SobieskiSat/ElectronicDesign20/README.txt

View this project on [CADLAB.io](https://cadlab.io/project/2295). 

Electronic design of the mainboard. more details TBA.
