SobieskiSat/ElectronicDesign20/projects/CanSat/Czopolot 2.0/Gerbers/Czopolot_Final1_1/CAMOutputs/Assembly/PnP_Schematic_back.txt

BTN_DFU	36.75	30.40	0.00	SLIDE-SWITCH2	SLIDE-SWITCH-2
BTN_RST	15.25	30.75	0.00	PUSH-SWITCH	SWITCH_SMD
BTN_USR	21.25	31.25	0.00	PUSH-SWITCH	SWITCH_SMD
BTN_USR1	27.25	31.25	0.00	PUSH-SWITCH	SWITCH_SMD
C16	31.20	30.85	90.00	4.7u	C0603
C28	50.25	12.75	180.00		153CLV-0405
C30	55.25	17.00	90.00	470n	C0603
C31	45.50	13.00	270.00	10u	C1206
C32	17.00	10.25	270.00	100n	C0603
C5	21.75	21.00	90.00	100n	C0603
C71	21.75	24.50	90.00	10n	C0603
LEDA	5.25	30.75	0.00	LED0805	CHIPLED_0805
LEDB	7.25	30.75	0.00	LED0805	CHIPLED_0805
LEDC	9.25	30.75	0.00	LED0805	CHIPLED_0805
LEDCH	55.25	20.75	0.00	LED0805	CHIPLED_0805
LEDD	11.25	30.75	0.00	LED0805	CHIPLED_0805
LEDP	45.25	20.75	0.00	LED0805	CHIPLED_0805
LM3940IMP	50.25	20.50	90.00	REGULATOR	SOT230P700X180-4N
R30	46.50	23.75	180.00	560R	R0603
R4	14.38	6.25	270.00	100k	R0603
R8	54.00	23.75	180.00	1k	R0603
R9	54.25	14.25	180.00	0R	R0603
U$13	35.00	4.98	180.00	MOTOR_DUO	4(2)X_JSTSMD_F
U$14	50.25	4.98	180.00	BAT_JST_4(3)	4(3)X_JSTSMD_F
U$17	22.00	4.98	180.00	MOTOR_DUO	4(2)X_JSTSMD_F
U$20	7.75	4.98	180.00	CONNECTOR_F_X3_JST_SMD	3X_JSTSMD_F
U$21	10.75	20.25	0.00	LORADUO	MODULE_SX1280
U$3	32.25	19.75	180.00	L86	L86
U$7	50.25	28.21	180.00	USB2.0	USB-C(2)
