SobieskiSat/ElectronicDesign20/projects/CanSat/Czopolot 2.0/Gerbers/Czopolot_Final1_1/CAMOutputs/Assembly/PnP_Schematic_front.txt

C0	5.75	24.50	180.00	100n	C0603
C1	8.50	9.50	225.00	100n	C0603
C11	11.75	31.25	0.00	100n	C0603
C12	6.25	17.75	270.00	15p	C0603
C13	1.75	21.50	90.00	15p	C0603
C14	2.25	24.50	180.00	10p	C0603
C15	6.25	21.50	90.00	10p	C0603
C17	28.50	8.00	90.00	100n	C0603
C18	41.50	8.00	90.00	100n	C0603
C19	28.50	4.75	0.00	10u	C1206
C20	45.50	22.50	270.00	1u	C0603
C21	50.25	23.25	180.00	33n	C0603
C22	47.50	22.50	90.00	1u	C0603
C23	55.00	14.00	270.00	1u	C0603
C24	55.00	18.50	270.00	22n	C0603
C25	41.50	4.75	180.00	10u	C1206
C26	39.50	8.00	90.00	50p	C0603
C27	26.50	8.00	90.00	50p	C0603
C3	24.25	22.25	0.00	100n	C0603
C4	11.75	26.75	0.00	100n	C0603
C50	11.75	28.75	0.00	1u	C0603
C6	4.00	14.00	270.00	4.7u	C0603
C7	1.75	14.00	270.00	100n	C0603
C70	24.25	28.75	180.00	100n	C0603
C72	24.25	26.75	0.00	100n	C0603
C8	17.25	9.50	225.00	2.2u	C0603
C80	9.00	30.50	90.00	10u	C0603
C9	24.25	20.00	0.00	2.2u	C0603
CBK	3.50	27.25	180.00	11m	CPH3225A
D1	7.00	30.50	90.00	DIODE	R0603
F1	6.25	14.00	90.00	1k	R0603
L2	54.50	22.50	315.00	1uH	INDUCTOR_VISHAY
R0	24.25	17.75	180.00	100k	R0603
R1	28.50	10.75	180.00	10k	R0603
R2	30.50	8.00	90.00	100k	R0603
R20	45.50	18.50	270.00	10k	R0603
R21	53.00	14.00	90.00	125R	R0603
R22	45.50	14.00	90.00	1k(NTC)/5k	R0603
R23	47.50	14.00	270.00	2k(NTC)/5k	R0603
R24	50.25	13.25	0.00	0R	R0603
R3	28.50	13.00	0.00	10k	DR0603
R5	39.00	10.75	180.00	10k	R0603
R6	5.00	30.50	90.00	0R	R0603
R7	38.25	13.00	0.00	10k	DR0603
U$1	14.50	17.75	0.00	STM32F405RGT6	QFP50P1200X1200X160-64N
U$10	50.25	18.50	45.00	BQ24253	QFN50P400X400X100-25T270N
U$11	35.00	8.00	270.00	TC78H653FTG	QFN50P300X300X90-17T170N
U$12	22.00	8.00	270.00	TC78H653FTG	QFN50P300X300X90-17T170N
U$15	19.75	31.25	180.00	RESISTORARRAY	0603-ARC
U$16	24.25	31.25	180.00	RESISTORARRAY	0603-ARC
U$19	50.25	5.23	180.00	CONNECTOR_F_X3_JST_SMD	3X_JSTSMD_F
U$2	34.16	23.06	0.00	MICROSD_HOLDER	MICROSD_HOLDER
U$26	15.25	31.25	180.00	RESISTORARRAY	0603-ARC
U$4	8.00	27.00	180.00	RESISTORARRAY	0603-ARC
U$5	4.00	21.50	270.00	32.768kHz / 12.5pF	OSC32X15
U$6	3.00	17.75	0.00	12MHz / 20pF	OSCCC320X250X80N
U$7	50.25	28.21	180.00	USB2.0	USB-C(2)
U$8	15.25	27.75	0.00	BMP280	BMP280
U$9	19.75	27.75	0.00	MPU9250USR	MPU9250
X1	10.25	5.13	0.00	FH12-24S-0.5SH	FH12-24S-0.5SH
