SobieskiSat/ElectronicDesign20/projects/CanSat/Czopolot 2.0/Prototype2_AssemblyDoc.pdf

# BQ24253 PAD 25

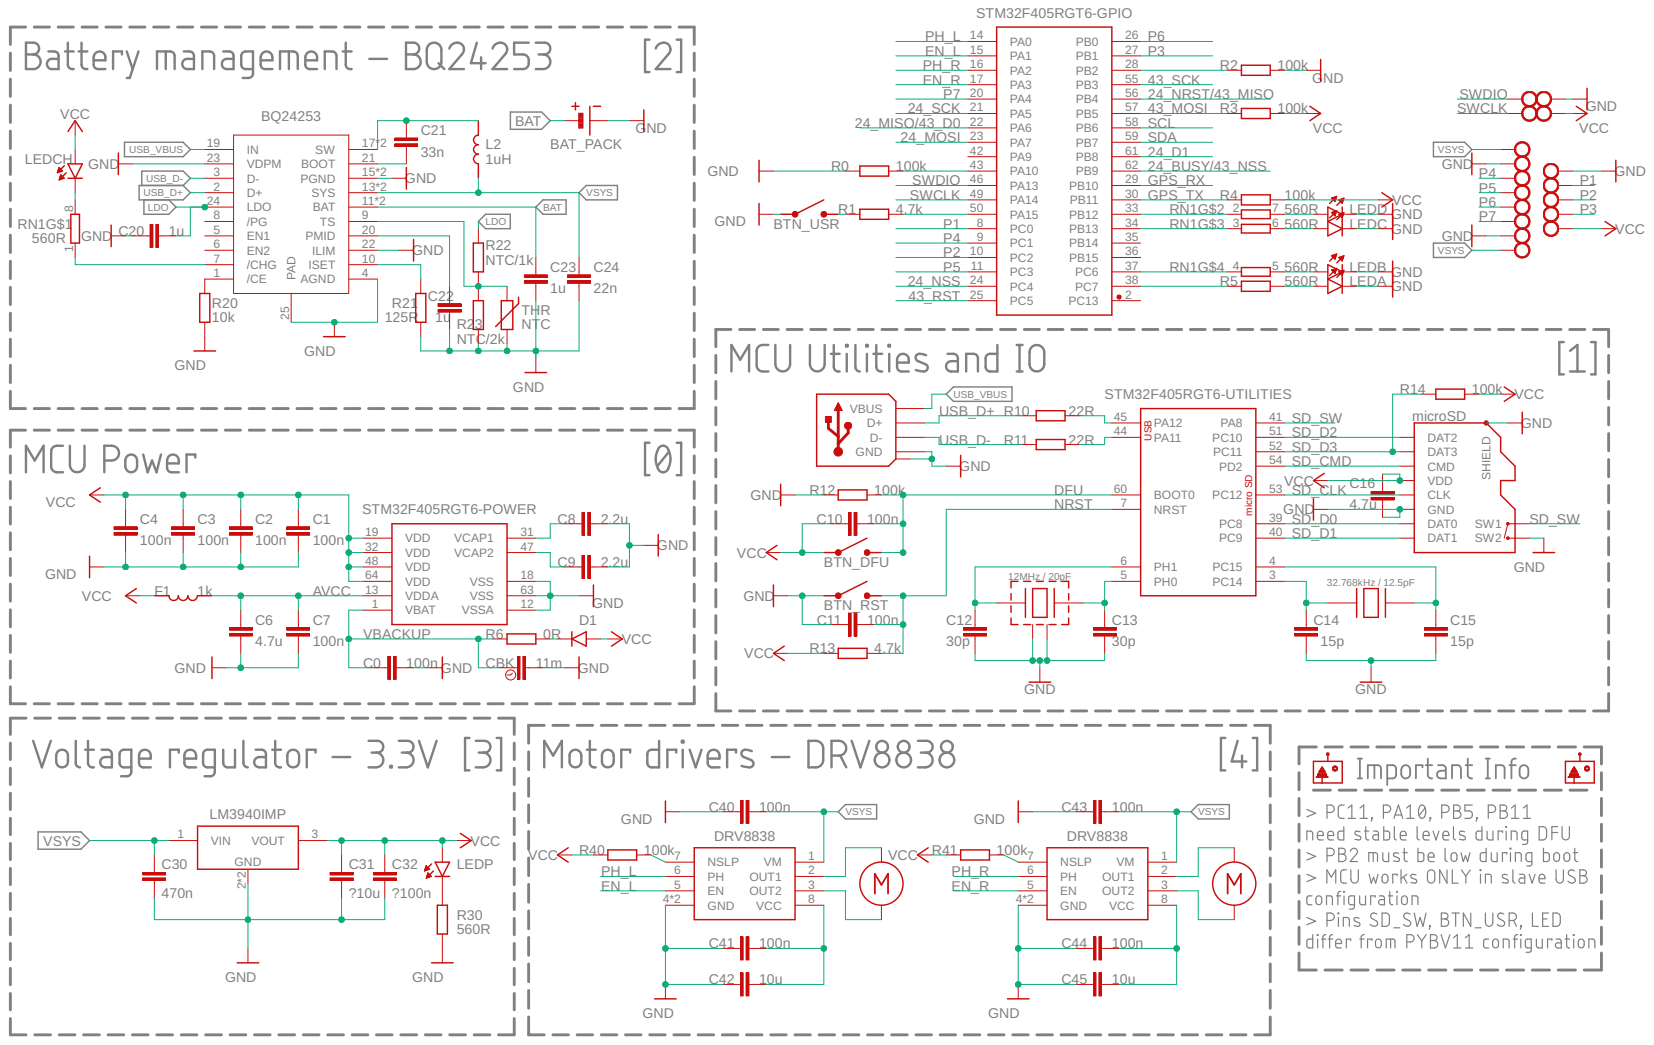
[picture p1: page 1]

NRST | NRST 7 | GND

BOM by part | | BOM by value
MCU ID: 0 | LDO ID: 3 | Cap | Res

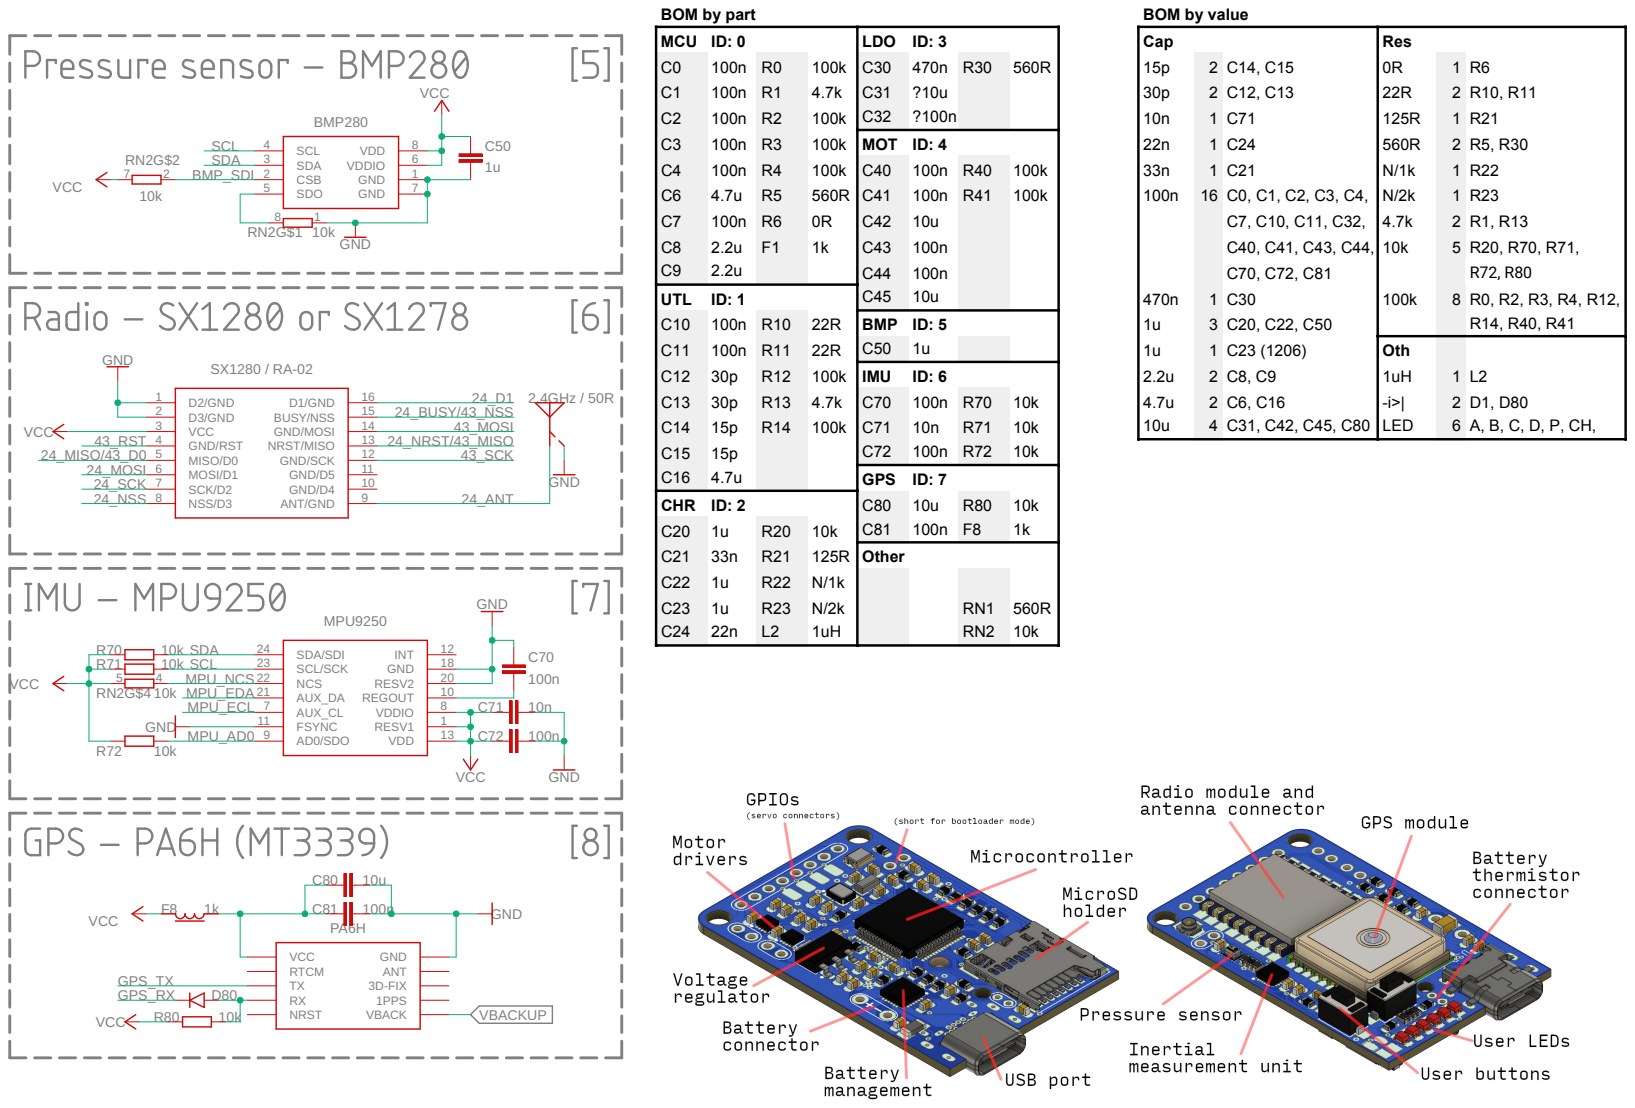
[picture p2: page 2]

## GND

1

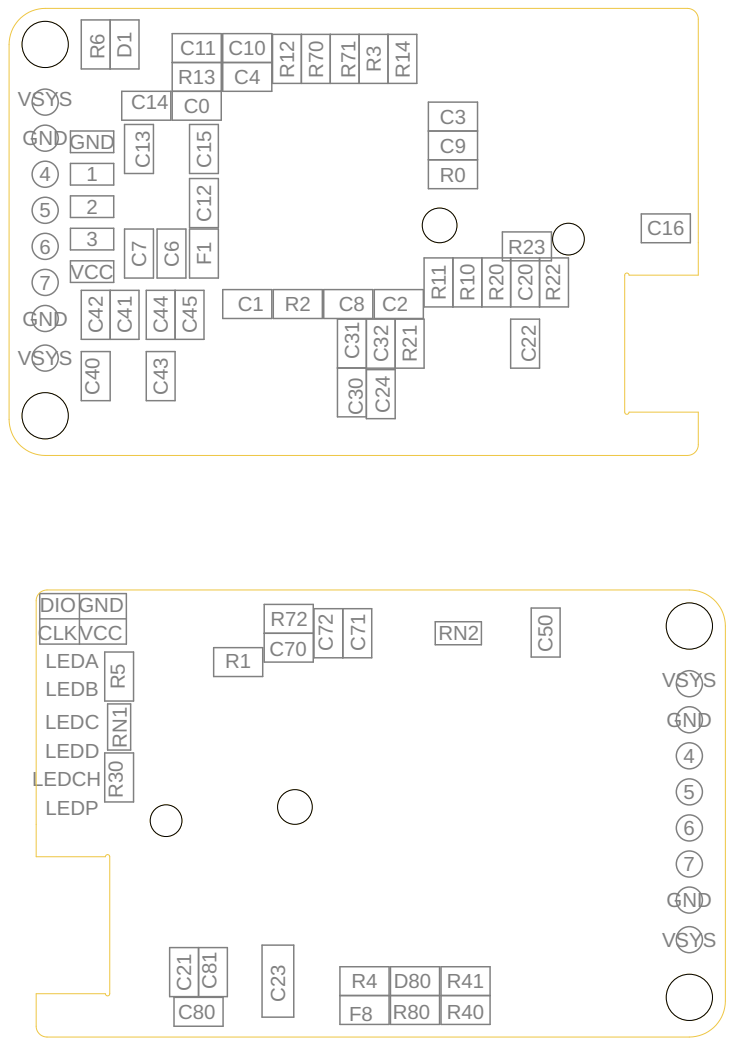
[picture p3: page 3]

DIO | GND

CLKVCC
