SobieskiSat/ElectronicDesign20/projects/CanSat/ExpansionBoard/ExpansionBoard.brd

## EAGLE design projects/CanSat/ExpansionBoard/ExpansionBoard.brd (2020-07-03)

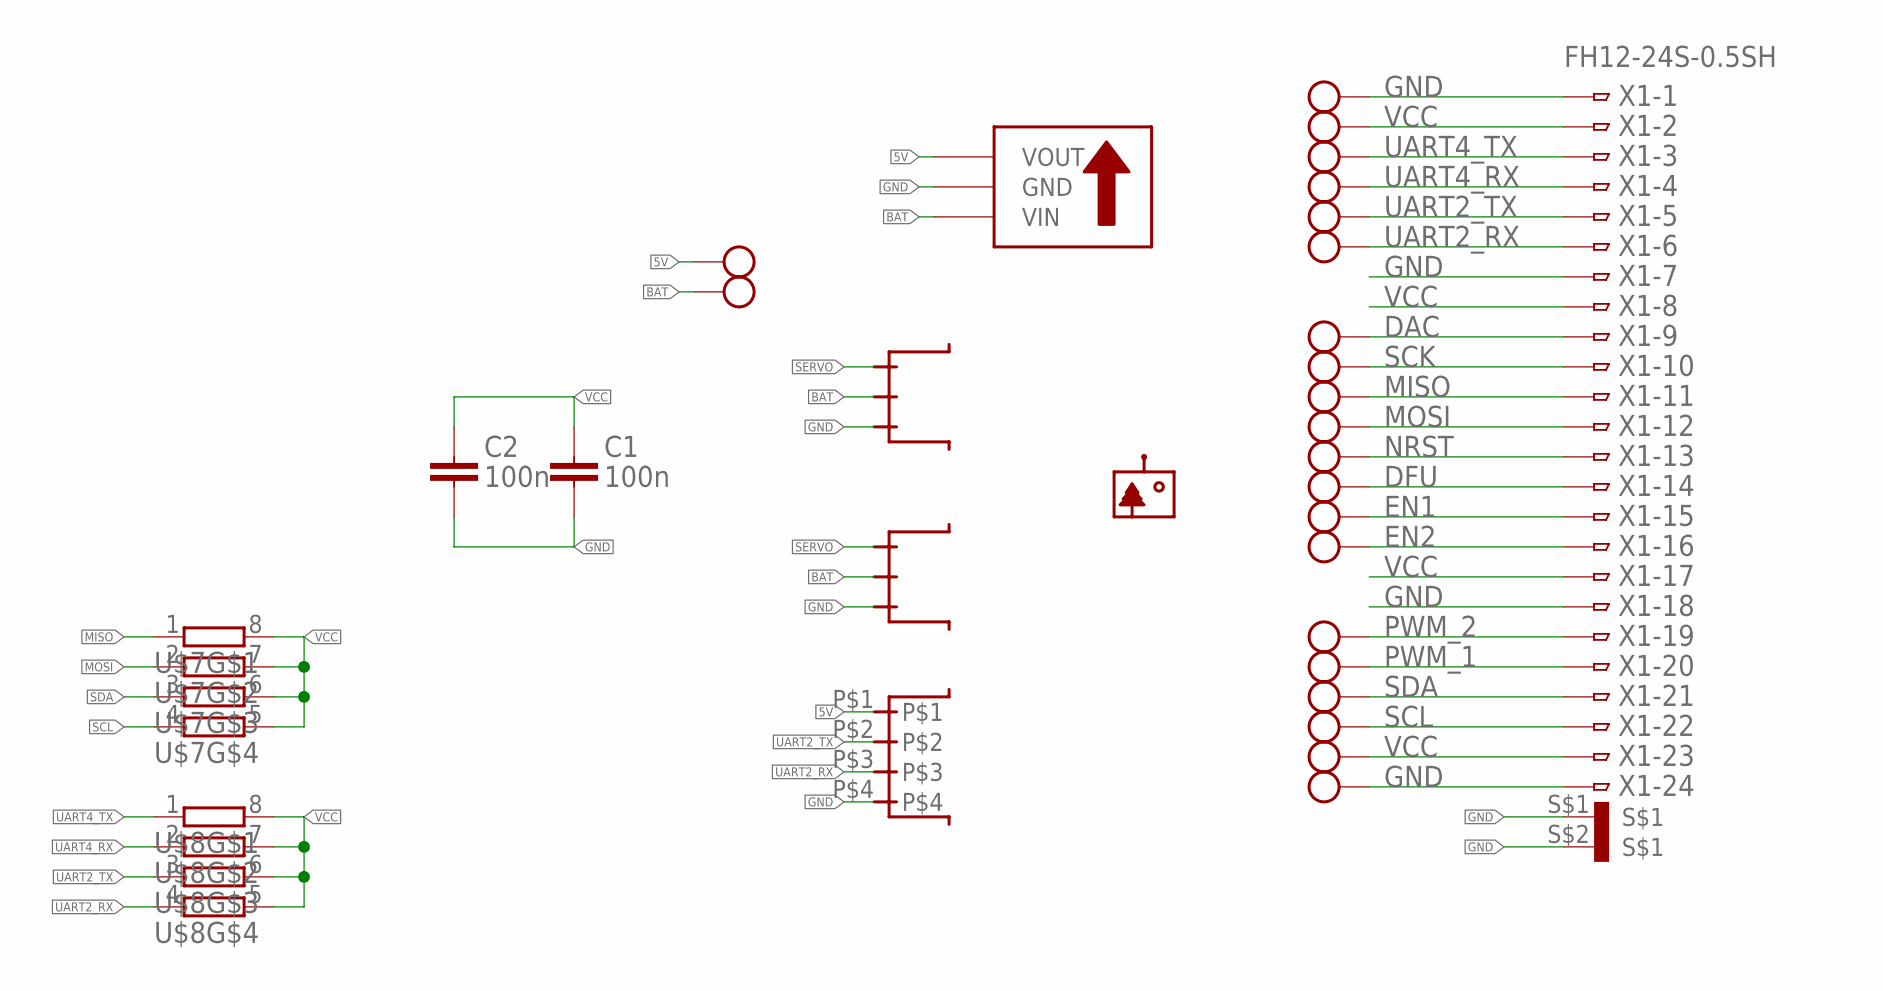
[picture p4: schematic ExpansionBoard.sch]

Parts:
C1, C2: 100n; C0603
U$1, U$23: THT_PADSQ; THT_PAD_SQ
U$2, U$3, U$4, U$5, U$6, U$9, U$10, U$11, U$12, U$13, U$14, U$15, U$16, U$19, U$20, U$21, U$22, U$24, U$27, U$30: THT_PAD
U$7, U$8: RESISTORARRAY; 0603-ARC
U$17: LOGOSQSM
U$25: MODULE_STEPUP
U$26: CONNECTOR_F_X4_JST_SMD; 4X_JSTSMD_F
U$28, U$29: CONNECTOR_F_X3_JST_SMD; 3X_JSTSMD_F
X1: FH12-24S-0.5SH

Connections:
5V: U$25.VOUT, U$26.P$1, U$27.P$1
BAT: U$25.VIN, U$28.P$2, U$29.P$2, U$30.P$1
DAC: U$9.P$1, X1.9 (1)
DFU: U$14.P$1, X1.14 (1)
EN1: U$15.P$1, X1.15 (1)
EN2: U$16.P$1, X1.16 (1)
GND: C1.2, C2.2, U$1.P$1, U$23.P$1, U$25.GND, U$26.P$4, U$28.P$3, U$29.P$3, X1.1, X1.7 (1), X1.18 (1), X1.24 (1), X1.S$1, X1.S$2
MISO: U$7.1, U$11.P$1, X1.11 (1)
MOSI: U$7.2 (1), U$12.P$1, X1.12 (1)
NRST: U$13.P$1, X1.13 (1)
PWM_1: U$20.P$1, X1.20 (1)
PWM_2: U$19.P$1, X1.19 (1)
SCK: U$10.P$1, X1.10 (1)
SCL: U$7.4 (1), U$22.P$1, X1.22 (1)
SDA: U$7.3 (1), U$21.P$1, X1.21 (1)
SERVO: U$28.P$1, U$29.P$1
UART2_RX: U$6.P$1, U$8.4 (1), U$26.P$3, X1.6 (1)
UART2_TX: U$5.P$1, U$8.3 (1), U$26.P$2, X1.5 (1)
UART4_RX: U$4.P$1, U$8.2 (1), X1.4 (1)
UART4_TX: U$3.P$1, U$8.1, X1.3 (1)
VCC: C1.1, C2.1, U$2.P$1, U$7.5 (2), U$7.6 (2), U$7.7 (2), U$7.8 (2), U$8.5 (2), U$8.6 (2), U$8.7 (2), U$8.8 (2), U$24.P$1, X1.2 (1), X1.8 (1), X1.17 (1), X1.23 (1)

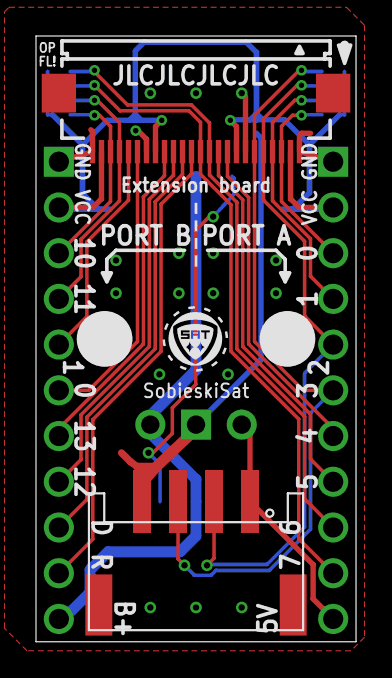
[picture p5: board ExpansionBoard.brd from above]

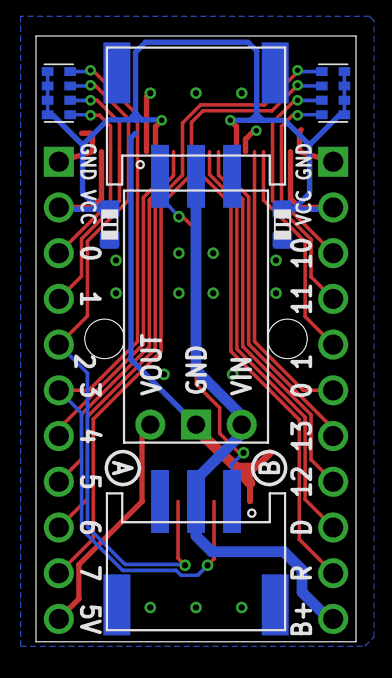
[picture p6: board ExpansionBoard.brd from below]

Board: 2 copper layers, 17.8 x 33.7 mm, 32 parts (7 on the bottom side), 21 nets.
