SobieskiSat/ElectronicDesign20/projects/CanSat/Czopolot 2.0/Schematic.brd

## EAGLE design projects/CanSat/Czopolot 2.0/Schematic.brd (2020-07-03)

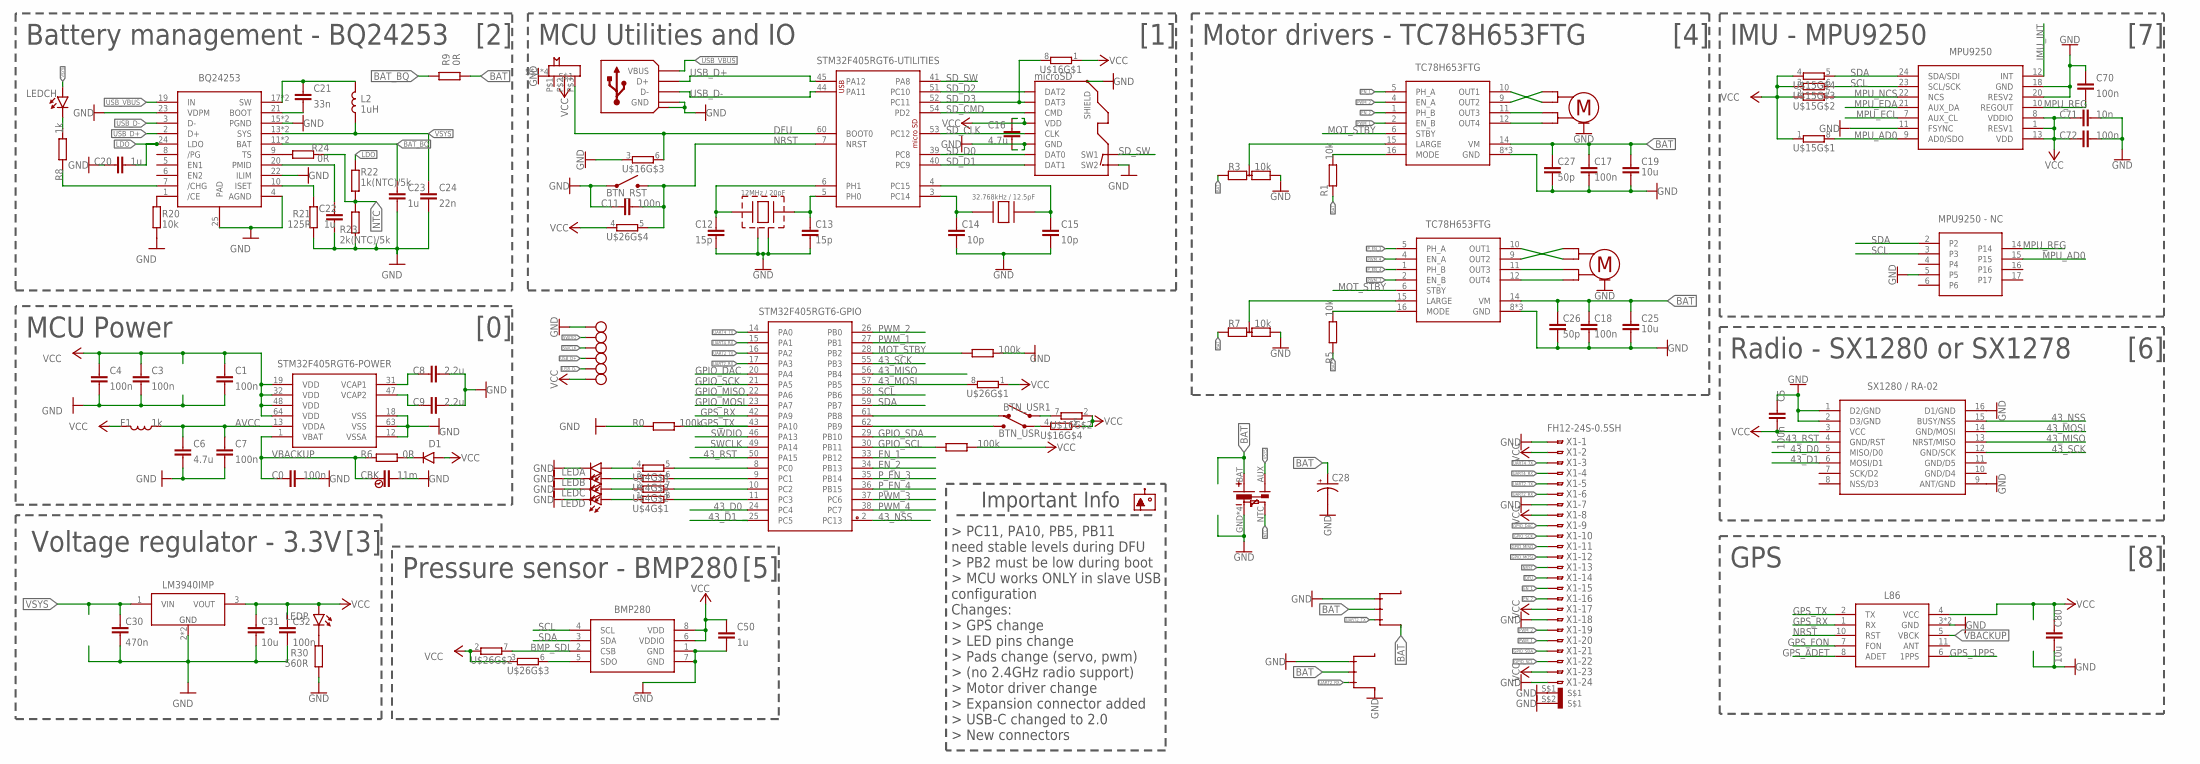
[picture p7: schematic Schematic.sch]

Parts:
BTN_DFU: SLIDE-SWITCH2; SLIDE-SWITCH-2
BTN_RST: PUSH-SWITCH; SWITCH_SMD
BTN_USR, BTN_USR1: PUSH-SWITCH; SWITCH_SMD
C0, C1, C3, C4, C5, C7, C11, C17, C18, C32, C70, C72: 100n; C0603
C6, C16: 4.7u; C0603
C8, C9: 2.2u; C0603
C12, C13: 15p; C0603
C14, C15: 10p; C0603
C19, C25, C31: 10u; C1206
C20, C22, C23, C50: 1u; C0603
C21: 33n; C0603
C24: 22n; C0603
C26, C27: 50p; C0603
C28: CPOL-US153CLV-0405; 153CLV-0405
C30: 470n; C0603
C71: 10n; C0603
C80: 10u; C0603
CBK: 11m; CPH3225A
D1: DIODE; R0603
F1: 1k; R0603
L2: 1uH; INDUCTOR_VISHAY
LEDA: LED0805; CHIPLED_0805
LEDB: LED0805; CHIPLED_0805
LEDC: LED0805; CHIPLED_0805
LEDCH: LED0805; CHIPLED_0805
LEDD: LED0805; CHIPLED_0805
LEDP: LED0805; CHIPLED_0805
LM3940IMP: REGULATOR; SOT230P700X180-4N
R0, R2, R4: 100k; R0603
R1, R5, R20: 10k; R0603
R3, R7: 10k; DR0603
R6, R9, R24: 0R; R0603
R8: 1k; R0603
R21: 125R; R0603
R22: 1k(NTC)/5k; R0603
R23: 2k(NTC)/5k; R0603
R30: 560R; R0603
U$1: STM32F405RGT6; QFP50P1200X1200X160-64N
U$2: MICROSD_HOLDER
U$3: L86
U$4, U$15, U$16, U$26: RESISTORARRAY; 0603-ARC
U$5: 32.768kHz / 12.5pF; OSC32X15
U$6: 12MHz / 20pF; OSCCC320X250X80N
U$7: USB2.0; USB-C(2)
U$8: BMP280
U$9: MPU9250USR; MPU9250
U$10: BQ24253; QFN50P400X400X100-25T270N
U$11, U$12: TC78H653FTG; QFN50P300X300X90-17T170N
U$13, U$17: MOTOR_DUO; 4(2)X_JSTSMD_F
U$14: BAT_JST_4(3); 4(3)X_JSTSMD_F
U$18: LOGOSQSM
U$19, U$20: CONNECTOR_F_X3_JST_SMD; 3X_JSTSMD_F
U$21: LORADUO; MODULE_SX1280
U$25: GPIO_DEBUG
X1: FH12-24S-0.5SH

Connections:
43_D0: U$1.24 (PC4), U$21.5 (MISO/D0)
43_D1: U$1.25 (PC5), U$21.6 (MOSI/D1)
43_MISO: U$1.56 (PB4), U$21.13 (NRST/MISO)
43_MOSI: U$1.57 (PB5), U$21.14 (GND/MOSI), U$26.8 (2)
43_NSS: U$1.2 (PC13), U$21.15 (BUSY/NSS)
43_RST: U$1.50 (PA15), U$21.4 (GND/RST)
43_SCK: U$1.55 (PB3), U$21.12 (GND/SCK)
AVCC: C6.1, C7.1, F1.2, U$1.13 (VDDA)
BAT: C17.1, C18.1, C19.1, C25.1, C26.1, C27.1, C28.+, R1.1, R3.2, R5.1, R7.2, R9.1, U$11.14 (VM), U$12.14 (VM), U$14.BAT (+), U$19.P$2, U$19.S$1, U$19.S$2, U$20.P$2
BAT_BQ: C23.1, R9.2, U$10.11 (BAT), U$10.12 (BAT)
BMP_SDI: U$8.2 (CSB), U$26.7 (2)
BMP_SDO: U$8.5 (SDO), U$26.6 (2)
DFU: BTN_DFU.P$3, U$1.60 (BOOT0), U$16.6 (2), X1.14 (1)
EN_1: U$1.33 (PB12), U$12.5 (PH_A), X1.15 (1)
EN_2: U$1.34 (PB13), U$12.1 (PH_B), X1.16 (1)
GND: BTN_DFU.S$1, BTN_DFU.S$2, BTN_DFU.S$3, BTN_DFU.S$4, BTN_RST.P$1, BTN_RST.P$4, C0.2, C1.2, C3.2, C4.2, C5.1, C6.2, C7.2, C8.2, C9.2, C11.1, C12.2, C13.2, C14.2, C15.2, C16.1, C17.2, C18.2, C19.2, C20.1, C22.2, C23.2, C24.2, C25.2, C26.2, C27.2, C28.-, C30.2, C31.2, C32.2, C50.2, C70.1, C71.2, C72.2, C80.2, CBK.P$2 (2), LEDA.C, LEDB.C, LEDC.C, LEDD.C, LM3940IMP.2 (GND), LM3940IMP.4 (GND), R0.1, R2.1, R3.3, R7.3, R20.1, R21.1, R23.1, R30.2, U$1.12 (VSSA), U$1.18 (VSS), U$1.63 (VSS), U$2.GND, U$2.SHIELD@1 (SHIELD), U$2.SHIELD@2 (SHIELD), U$2.SHIELD@3 (SHIELD), U$2.SHIELD@4 (SHIELD), U$2.SW2, U$3.3 (GND), U$3.12 (GND), U$6.2 (GND), U$6.4 (GND), U$7.A1 (GND), U$7.A12 (GND), U$7.B1 (GND), U$7.B12 (GND), U$7.MID@1 (SHIELD), U$7.MID@2 (SHIELD), U$7.S$1 (GND), U$7.S$2 (GND), U$7.S$3 (GND), U$7.S$4 (GND), U$7.S$5 (GND), U$7.S$6 (GND), U$7.S$7 (GND), U$7.S$8 (GND), U$8.1 (GND), U$8.7 (GND), U$9.5, U$9.11 (FSYNC), U$9.18 (GND), U$9.20 (RESV2), U$10.4 (AGND), U$10.15 (PGND), U$10.16 (PGND), U$10.22 (ILIM), U$10.23 (VDPM), U$10.25 (PAD), U$11.8 (GND), U$11.13 (GND), U$11.17 (GND), U$12.8 (GND), U$12.13 (GND), U$12.17 (GND), U$13.S$1, U$13.S$2, U$13.S$3, U$13.S$4, U$14.GND (-), U$14.S$1 (-), U$14.S$2 (-), U$14.S$3 (-), U$16.3 (1), U$17.S$1, U$17.S$2, U$17.S$3, U$17.S$4, U$19.P$1, U$20.P$1, U$20.S$1, U$20.S$2, U$21.1 (D2/GND), U$21.2 (D3/GND), U$21.9 (ANT/GND), U$21.16 (D1/GND), U$25.P$1, X1.1, X1.7 (1), X1.18 (1), X1.24 (1), X1.S$1, X1.S$2
GPIO_DAC: U$1.20 (PA4), X1.9 (1)
GPIO_MISO: U$1.22 (PA6), X1.11 (1)
GPIO_MOSI: U$1.23 (PA7), X1.12 (1)
GPIO_SCK: U$1.21 (PA5), X1.10 (1)
GPIO_SCL: R4.2, U$1.30 (PB11), X1.22 (1)
GPIO_SDA: U$1.29 (PB10), X1.21 (1)
GPS_1PPS: U$3.6 (1PPS)
GPS_ADET: U$3.8 (ADET)
GPS_FON: U$3.7 (FON)
GPS_RX: U$1.42 (PA9), U$3.1 (RX)
GPS_TX: R0.2, U$1.43 (PA10), U$3.2 (TX)
IMU_INT: U$9.12 (INT)
LDO: C20.2, R22.2, U$10.24 (LDO)
MOT_STBY: R2.2, U$1.28 (PB2), U$11.6 (STBY), U$12.6 (STBY)
MPU_AD0: U$9.9 (AD0/SDO), U$9.15, U$15.8 (2)
MPU_ECL: U$9.7 (AUX_CL)
MPU_EDA: U$9.21 (AUX_DA)
MPU_NCS: U$9.22 (NCS), U$15.7 (2)
MPU_REG: C70.2, U$9.10 (REGOUT), U$9.14
unnamed: LEDD.A, U$4.1
unnamed: LEDC.A, U$4.2 (1)
unnamed: LEDCH.C, R8.2
unnamed: U$11.9 (OUT2), U$13.P$1
unnamed: BTN_USR.P$2, BTN_USR.P$3, U$1.62 (PB9)
unnamed: C21.2, U$10.21 (BOOT)
unnamed: BTN_USR.P$1, BTN_USR.P$4, U$16.4 (1)
unnamed: C9.1, U$1.47 (VCAP2)
unnamed: C8.1, U$1.31 (VCAP1)
unnamed: R8.1, U$10.7 (/CHG)
unnamed: C12.1, U$1.6 (PH1), U$6.1
unnamed: C13.1, U$1.5 (PH0), U$6.3
unnamed: C14.1, U$1.3 (PC14), U$5.P$1
unnamed: C15.1, U$1.4 (PC15), U$5.P$2
unnamed: U$1.8 (PC0), U$4.5 (2)
unnamed: R24.2, U$10.9 (TS)
unnamed: R21.2, U$10.10 (ISET)
unnamed: U$1.11 (PC3), U$4.8 (2)
unnamed: U$1.10 (PC2), U$4.7 (2)
unnamed: C21.1, L2.P$1, U$10.17 (SW), U$10.18 (SW)
unnamed: LEDP.C, R30.1
unnamed: U$11.10 (OUT1), U$13.P$2
unnamed: C22.1, U$10.20 (PMID)
unnamed: BTN_USR1.P$1, BTN_USR1.P$4, U$16.7 (2)
unnamed: U$1.9 (PC1), U$4.6 (2)
unnamed: R20.2, U$10.1 (/CE)
unnamed: BTN_USR1.P$2, BTN_USR1.P$3, U$1.61 (PB8)
unnamed: U$11.11 (OUT3), U$13.P$3
unnamed: U$11.12 (OUT4), U$13.P$4
unnamed: U$12.9 (OUT2), U$17.P$1
unnamed: U$12.10 (OUT1), U$17.P$2
unnamed: U$12.11 (OUT3), U$17.P$3
unnamed: U$12.12 (OUT4), U$17.P$4
unnamed: R1.2, U$12.16 (MODE)
unnamed: LEDB.A, U$4.3 (1)
unnamed: LEDA.A, U$4.4 (1)
unnamed: R3.1, U$12.15 (LARGE)
unnamed: R5.2, U$11.16 (MODE)
unnamed: D1.2, R6.2
unnamed: R7.1, U$11.15 (LARGE)
NRST: BTN_RST.P$2, BTN_RST.P$3, C11.2, U$1.7 (NRST), U$3.10 (RST), U$26.5 (2), X1.13 (1)
NTC: R22.1, R23.2, R24.1, U$14.NTC
PWM_1: U$1.27 (PB1), U$12.2 (EN_B), X1.20 (1)
PWM_2: U$1.26 (PB0), U$12.4 (EN_A), X1.19 (1)
PWM_3: U$1.37 (PC6), U$11.2 (EN_B)
PWM_4: U$1.38 (PC7), U$11.4 (EN_A)
P_EN_3: U$1.35 (PB14), U$11.5 (PH_A)
P_EN_4: U$1.36 (PB15), U$11.1 (PH_B)
SCL: U$1.58 (PB6), U$8.4 (SCL), U$9.3, U$9.23 (SCL/SCK), U$15.6 (2)
SDA: U$1.59 (PB7), U$8.3 (SDA), U$9.2, U$9.24 (SDA/SDI), U$15.5 (2)
SD_CLK: U$1.53 (PC12), U$2.CLK
SD_CMD: U$1.54 (PD2), U$2.CMD
SD_D0: U$1.39 (PC8), U$2.D0 (DAT0)
SD_D1: U$1.40 (PC9), U$2.D1 (DAT1)
SD_D2: U$1.51 (PC10), U$2.D2 (DAT2)
SD_D3: U$1.52 (PC11), U$2.D3 (DAT3), U$16.8 (2)
SD_SW: U$1.41 (PA8), U$2.SW1
SWCLK: U$1.49 (PA14), U$25.P$3
SWDIO: U$1.46 (PA13), U$25.P$2
UART2_RX: U$1.17 (PA3), U$20.P$3, X1.6 (1)
UART2_TX: U$1.16 (PA2), U$19.P$3, X1.5 (1)
UART4_RX: U$1.15 (PA1), X1.4 (1)
UART4_TX: U$1.14 (PA0), X1.3 (1)
USB_D+: U$1.45 (PA12), U$7.A6 (D+), U$7.B6 (D+), U$10.2 (D+), U$25.P$4
USB_D-: U$1.44 (PA11), U$7.A7 (D-), U$7.B7 (D-), U$10.3 (D-), U$25.P$5
USB_VBUS: U$7.A4 (VBUS), U$7.A9 (VBUS), U$7.B4 (VBUS), U$7.B9 (VBUS), U$10.19 (IN)
VBACKUP: C0.1, CBK.P$1 (1), R6.1, U$1.1 (VBAT), U$3.5 (VBCK)
VCC: BTN_DFU.P$2, C1.1, C3.1, C4.1, C5.2, C16.2, C31.1, C32.1, C50.1, C71.1, C72.1, C80.1, D1.1, F1.1, LEDP.A, LM3940IMP.3 (VOUT), R4.1, U$1.19 (VDD), U$1.32 (VDD), U$1.48 (VDD), U$1.64 (VDD), U$2.VCC (VDD), U$3.4 (VCC), U$8.6 (VDDIO), U$8.8 (VDD), U$9.1 (RESV1), U$9.8 (VDDIO), U$9.13 (VDD), U$15.1, U$15.2 (1), U$15.3 (1), U$15.4 (1), U$16.1, U$16.2 (1), U$16.5 (2), U$21.3 (VCC), U$25.P$6, U$26.1, U$26.2 (1), U$26.3 (1), U$26.4 (1), X1.2 (1), X1.8 (1), X1.17 (1), X1.23 (1)
VSYS: C24.1, C30.1, L2.P$2, LEDCH.A, LM3940IMP.1 (VIN), U$10.13 (SYS), U$10.14 (SYS), U$14.AUX (AUX+)

Notes on the sheet:
GPS
Pressure sensor - BMP280
IMU - MPU9250
Radio - SX1280 or SX1278
Battery management - BQ24253
Voltage regulator - 3.3V
MCU Power
MCU Utilities and IO
Important Info
Motor drivers - TC78H653FTG
[0]
[1]
[2]
[3]
[4]
[5]
[6]
[7]
[8]
Changes: > GPS change > LED pins change > Pads change (servo, pwm) > (no 2.4GHz radio support) > Motor driver change > Expansion connector added > USB-C changed to 2.0 > New connectors

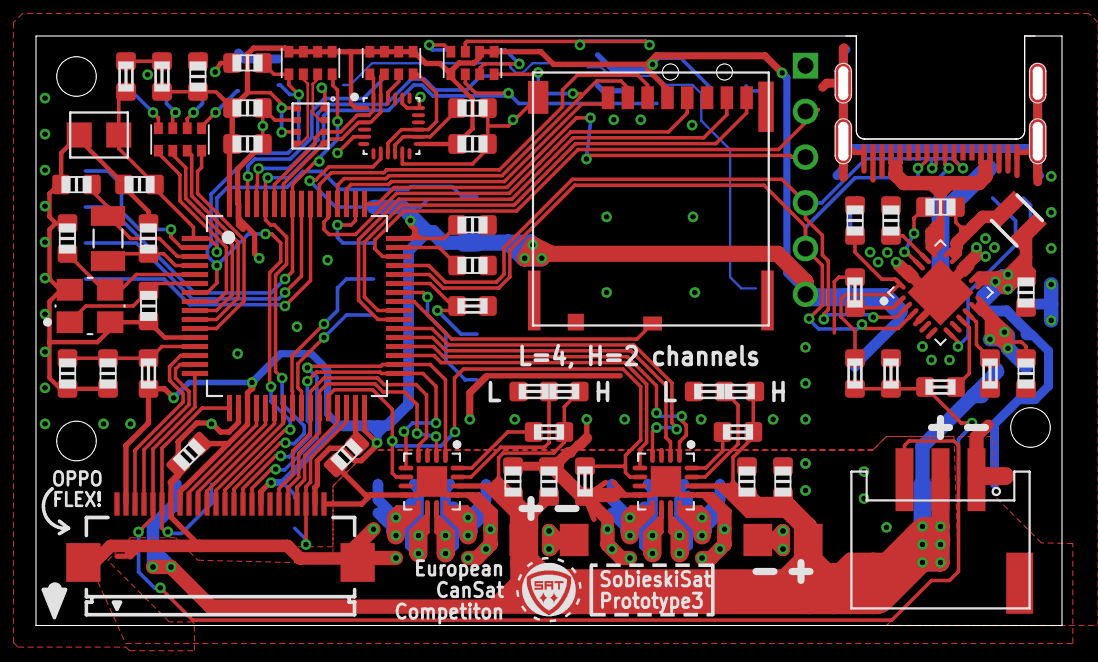
[picture p8: board projects/CanSat/Czopolot 2.0/Schematic.brd from above]

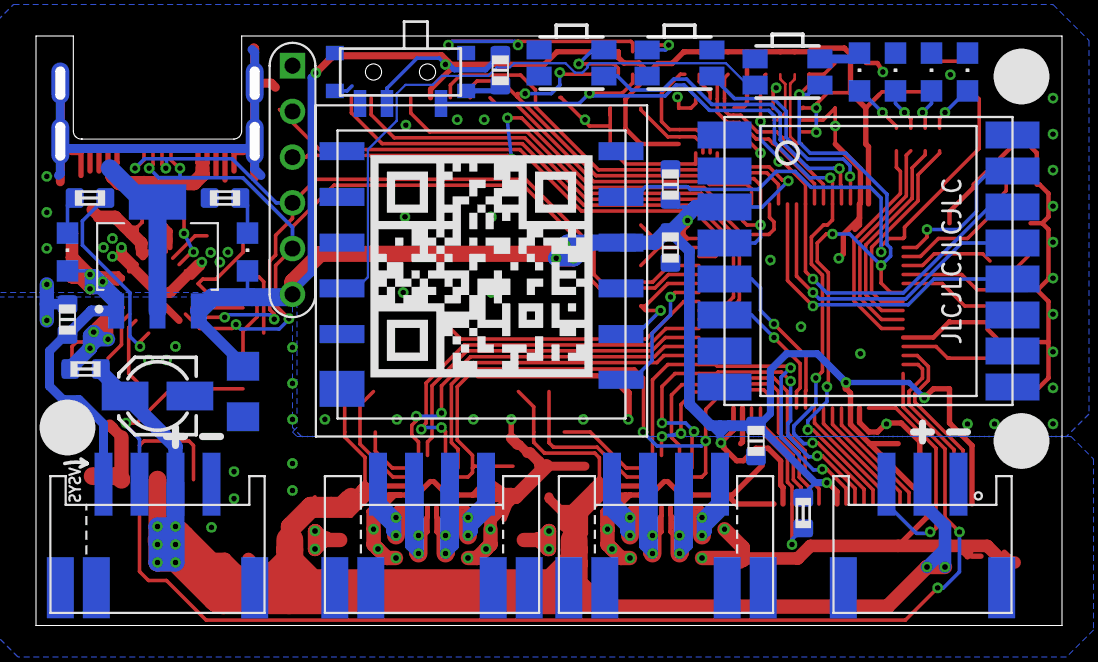
[picture p9: board projects/CanSat/Czopolot 2.0/Schematic.brd from below]

Board: 2 copper layers, 57.0 x 32.8 mm, 90 parts (29 on the bottom side), 98 nets.
