SobieskiSat/ElectronicDesign20/projects/CanSat/Czopolot 1.0/schematic.brd

## EAGLE design projects/CanSat/Czopolot 1.0/schematic.brd (2019-12-15)

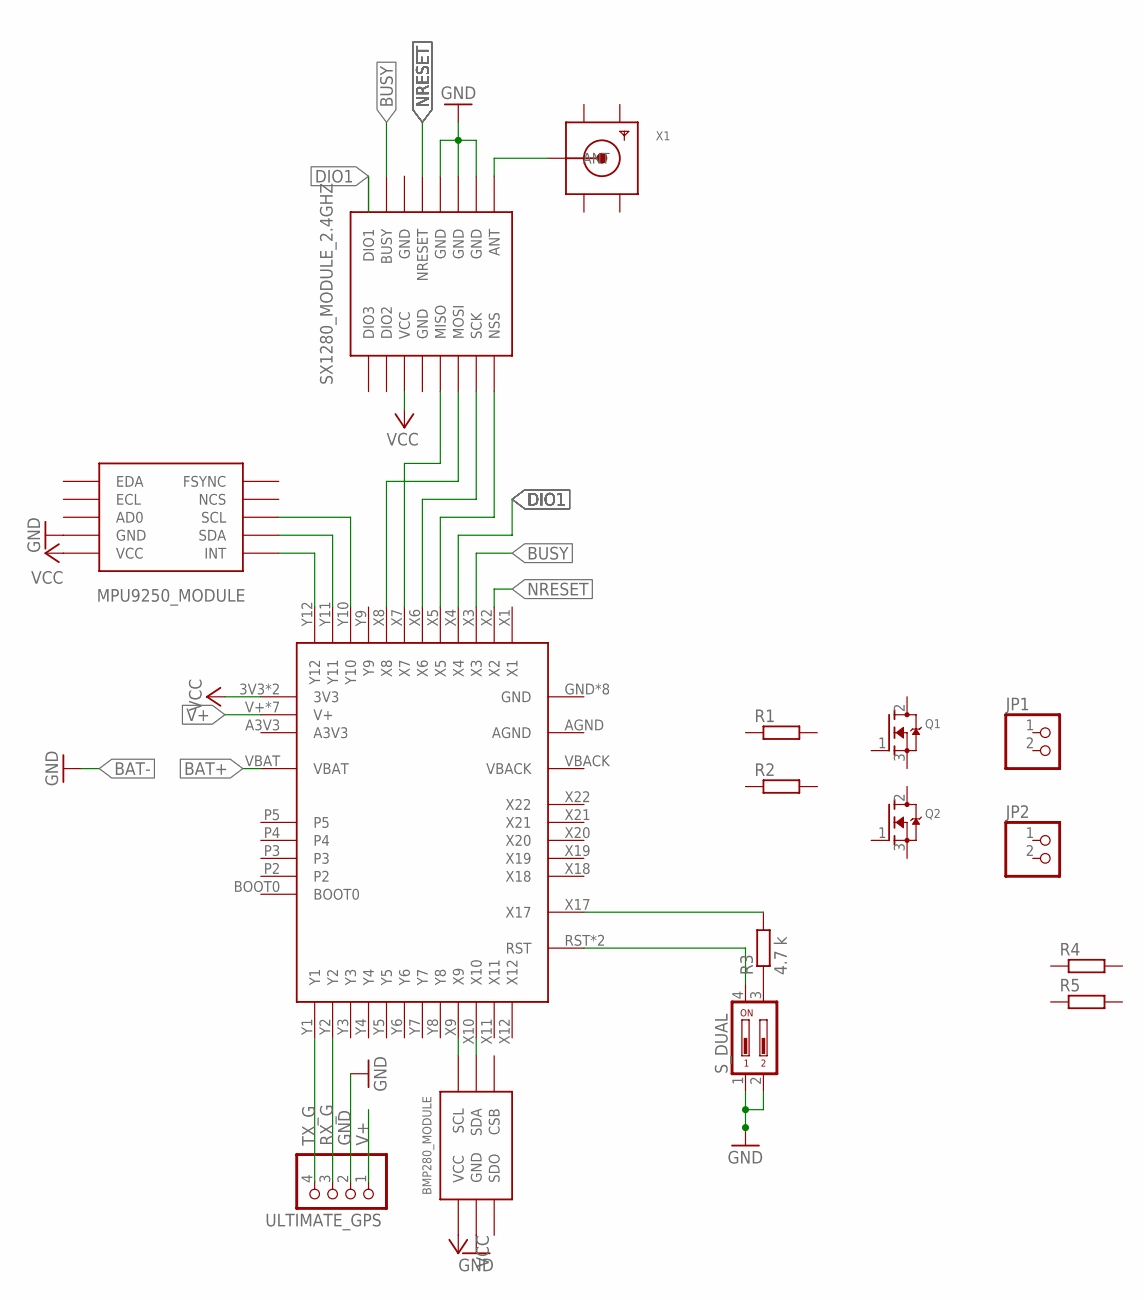
[picture p10: schematic schematic.sch]

Parts:
JP1, JP2: PINHD-1X2; 1X02
Q1, Q2: MOSFET-NGDS_TO220V; TO220V
R1, R2, R4: R-EU_0204/7; 0204/7
R3: 4.7 k; 0204/7
R5: R-EU_0207/10; 0207/10
U$1: PYBOARD1.1; MODULE_PYBOARD
U$3: MPU9250; MODULE_MPU9250
U$4: BMP280; MODULE_BMP280
U$5: SWITCH_DUAL
U$6: SX1280_2.4GHZ; MODULE_SX1280_THT
ULTIMATE_GPS: PINHD-1X4; 1X04
X1: SMACONNECTOR; SMA_DIP

Connections:
BAT+: U$1.VBAT
BUSY: U$1.X3, U$6.BUSY
DIO1: U$1.X4
GND: U$3.GND, U$4.GND, U$5.1, U$5.2, U$6.GND@3 (GND), U$6.GND@4 (GND), U$6.GND@5 (GND), ULTIMATE_GPS.2
GND1: X1.GND1
GND2: X1.GND2
GND3: X1.GND3
GND4: X1.GND4
unnamed: U$1.X5, U$6.NSS
unnamed: U$1.X6, U$6.SCK
unnamed: U$1.X8, U$6.MOSI
unnamed: U$1.X7, U$6.MISO
unnamed: U$6.ANT, X1.ANTENNA (ANT)
unnamed: R3.1, U$5.3
unnamed: U$1.Y11, U$3.SDA
unnamed: U$1.Y10, U$3.SCL
unnamed: U$1.Y12, U$3.INT
unnamed: U$1.X9, U$4.SCL
unnamed: U$1.X10, U$4.SDA
unnamed: U$1.RST, U$1.RST1 (RST), U$5.4
unnamed: R3.2, U$1.X17
NRESET: U$1.X2, U$6.NRESET
RX_G: U$1.Y2, ULTIMATE_GPS.3
TX_G: U$1.Y1, ULTIMATE_GPS.4
V+: U$1.V+, U$1.V+1 (V+), U$1.V+2 (V+), U$1.V+3 (V+), U$1.V+4 (V+), U$1.V+5 (V+), U$1.V+6 (V+), ULTIMATE_GPS.1
VCC: U$1.3V3, U$1.3V3-1 (3V3), U$3.VCC, U$4.VCC, U$6.VCC

Board: 2 copper layers, 16 parts (0 on the bottom side), 20 nets, no tracks yet.
