SobieskiSat/ElectronicDesign20/(commit log)

2019-11-18 File upload
    [Schematic.brd, Schematic.sch, schematic.brd, schematic.sch]
2019-11-18 File separation
    [Schematic.brd, Schematic.sch, schematic.brd, schematic.sch]
2019-11-18 File update
    [schematic.brd, schematic.sch]
2019-11-25 Work work..
    [Schematic.brd, Schematic.sch, schematic.brd, schematic.sch]
2019-11-26 Work work...
    [Schematic.brd, Schematic.sch]
2019-12-01 Work work.....
    [Schematic.brd, Schematic.sch]
2019-12-04 updatejs
    pyboard
    [schematic.brd]
2019-12-05 Routing & placing ver.1
    Proposed routing for board.
    > Everyting seems optimal so far except for:
    > BMP280 (?move to the right)
    [Schematic.brd, Schematic.sch]
2019-12-08 Oh God that's small..
    [Schematic.brd, Schematic.sch]
2019-12-09 USB-C update
    [Schematic.brd, Schematic.sch]
2019-12-09 Backup upload
    [Schematic.brd]
2019-12-09 Proposed routing ver.2
    [Schematic.brd]
2019-12-09 Jeezz it's tiny...
    [Schematic.brd, Schematic.sch]
2019-12-10 Switch added
    Duel switch and resistor added
    Resistor type switched to another to match the grid
    [schematic.brd, schematic.sch]
2019-12-10 Added GND to switch
    [schematic.brd, schematic.sch]
2019-12-11 Work work
    [Schematic.brd, Schematic.sch]
2019-12-12 Schematic changes
    BQ25606 replaced with 24270
    USB OTG replaced with USB
    [Schematic.brd, Schematic.sch]
2019-12-12 updated charging solution
    Swapped BQ24270 for a newer BQ24253
2019-12-12 Updated charging solution for czopolot 2.0
    Schematic update
    [Schematic.brd, Schematic.sch]
2019-12-13 change in ppm
    Damian co ty tam zmieniasz LDO na VIN???
    [Schematic.brd, Schematic.sch]
2019-12-13 charging work
    [Schematic.brd, Schematic.sch]
2019-12-15 Switched SX1280
    [schematic.brd, schematic.sch]
2019-12-16 Finished version 0.1
    -Full routing
    -Bad footprints
    [Schematic.brd, Schematic.sch]
2019-12-16 Motor driver added
    [Schematic.brd, Schematic.sch]
2019-12-22 fusion sync
    [Schematic.brd]
2019-12-28 Revert "Motor driver added"
    This reverts commit 75eb9b0d133b9a877f65968a5a8719895b875b89.
    [Schematic.brd, Schematic.sch]
2019-12-28 Version 0.2
    [Schematic.brd, Schematic.sch]
2019-12-29 Version 0.3
    [Schematic.brd, Schematic.sch]
2019-12-29 Motor driver changed
    [Schematic.brd, Schematic.sch]
2020-01-04 some 3D models added
    [Schematic.brd, Schematic.sch]
2020-01-04 3D Models added
    [Schematic.brd, Schematic.sch]
2020-01-04 Pheripherials added
    [Schematic.brd, Schematic.sch]
2020-01-05 Version 0.4
    [Schematic.brd, Schematic.sch]
2020-01-05 fusion link change
    [Schematic.brd]
2020-01-05 charger, NTC, minro improements
    [Schematic.brd, Schematic.sch]
2020-01-05 minor improvements
    SD generally
    [Schematic.brd]
2020-01-06 minor changes
    [Schematic.brd]
2020-01-06 fusion transfer
    [Schematic.brd]
2020-01-06 Screwholes added
    [Schematic.brd, Schematic.sch]
2020-01-06 Version 0.5
    Pre-final component placement
    [Schematic.brd, Schematic.sch]
2020-01-06 Round traces test
    [Schematic.brd, Schematic.sch]
2020-01-07 Pads backup
    [Schematic.brd, Schematic.sch]
2020-01-07 VERSION 1.0.0
    [Schematic.brd, Schematic.sch]
2020-01-07 433MHz support added
    [Schematic.brd, Schematic.sch]
2020-01-09 Schematic updated for CDR
    [Schematic.brd, Schematic.sch]
2020-01-09 schematic arrangement
    [Schematic.sch]
2020-01-15 Version 1.1
    [Schematic.brd, Schematic.sch]
2020-01-15 Small update
    [Schematic.brd]
2020-01-15 Revert "Small update"
    This reverts commit c373715e058d3e625b4769dc3f0669b20e7862ed.
    [Schematic.brd]
2020-01-15 pre-order check
    [Schematic.brd]
2020-01-15 Micro update
    [Schematic.brd, Schematic.sch]
2020-01-16 changed slots for USBC to BIG HOLES
    [Schematic.brd, Schematic.sch]
2020-01-16 minor changes + new gerber
    [Schematic.brd]
2020-01-16 fusion update
    [Schematic.brd]
2020-01-16 Schematic values updated
    [Schematic.sch]
2020-01-18 Assembly document added
    [Schematic.brd, Schematic.sch]
2020-03-08 New version work
    [Schematic.brd, Schematic.sch]
2020-03-08 added 0R at TS pin of charger
    [Schematic.brd, Schematic.sch]
2020-03-09 Before global ripup
    [Schematic.brd, Schematic.sch]
2020-03-10 corona fajranto despacito
    [Schematic.brd, Schematic.sch]
2020-03-26 Before driver change
    [Schematic.brd, Schematic.sch]
2020-04-12 Microcontroller and sensors done...
    [Schematic.brd, Schematic.sch]
2020-04-13 Dual motor connectors added
    [Schematic.brd, Schematic.sch]
2020-06-25 V2 work...
    [Schematic.brd, Schematic.sch]
2020-06-28 V2 almost done
    [Schematic.brd, Schematic.sch]
2020-06-29 GND yet to fix
    [Schematic.brd, Schematic.sch]
2020-07-02 Extension board
    [ExpansionBoard.brd, ExpansionBoard.sch, Schematic.brd, Schematic.sch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]
2020-07-03 Before ordering
    [ExpansionBoard.brd, ExpansionBoard.sch, Schematic.brd, Schematic.sch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]
